jaromir-sukuba/vm_mini/readme.md

# 6-digit handheld digital volt-ohm-meter
This is repository for JVO-2
This readme is still incomplete. Find more information here
https://www.eevblog.com/forum/metrology/diy-6-digit-handheld-volohmmeter/
https://imgur.com/a/50MBxly
