jaromir-sukuba/vm_mini/mech/LM399_cover_part1.stl

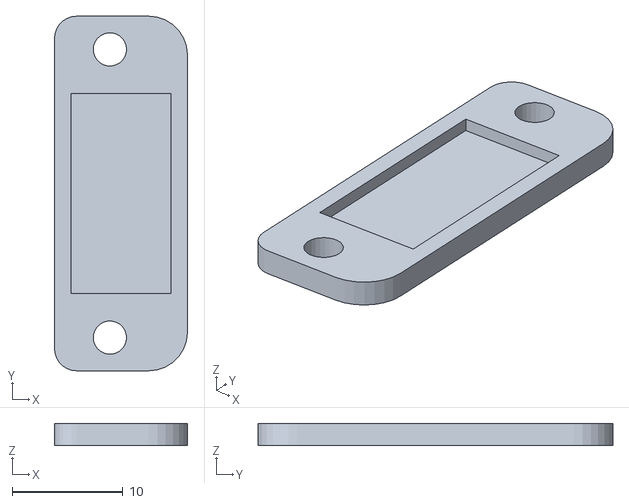
[picture p1: CAD file, 2020-03-22]
mech/LM399_cover_part1.stl
12.0 x 32.0 x 2.00
