jaromir-sukuba/vm_mini/mech/LM399_cover_part2.stl

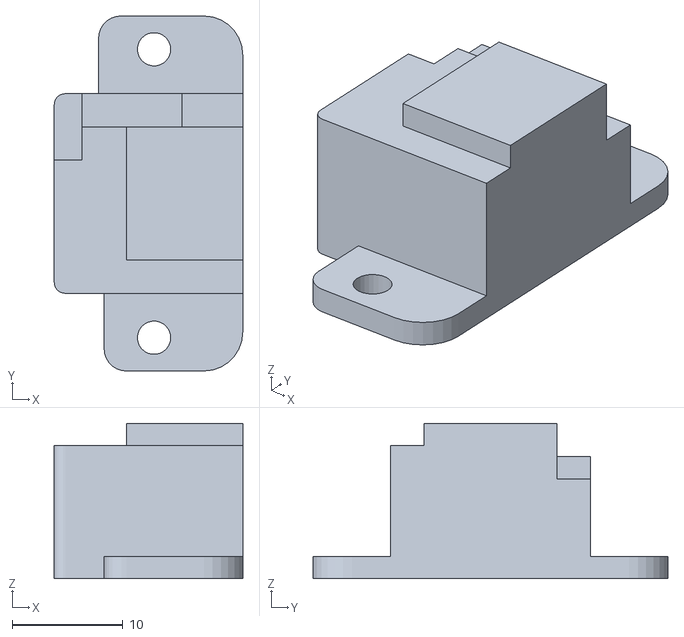
[picture p2: CAD file, 2020-03-22]
mech/LM399_cover_part2.stl
17.0 x 32.0 x 14.0
