jaromir-sukuba/vm_mini/schematics_pdf/vm_mini_analog_board.pdf

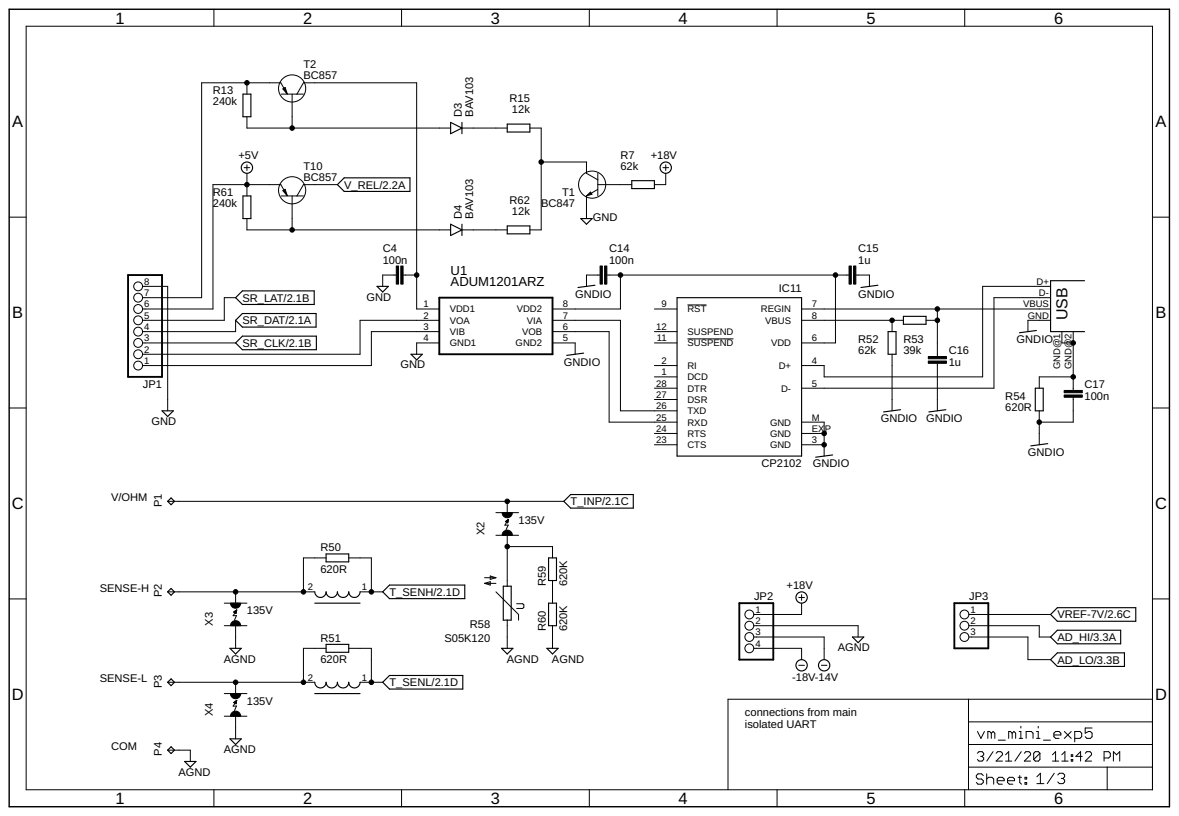
[picture p3: page 1]

D+D- VBUS GND GND@1 GND@2

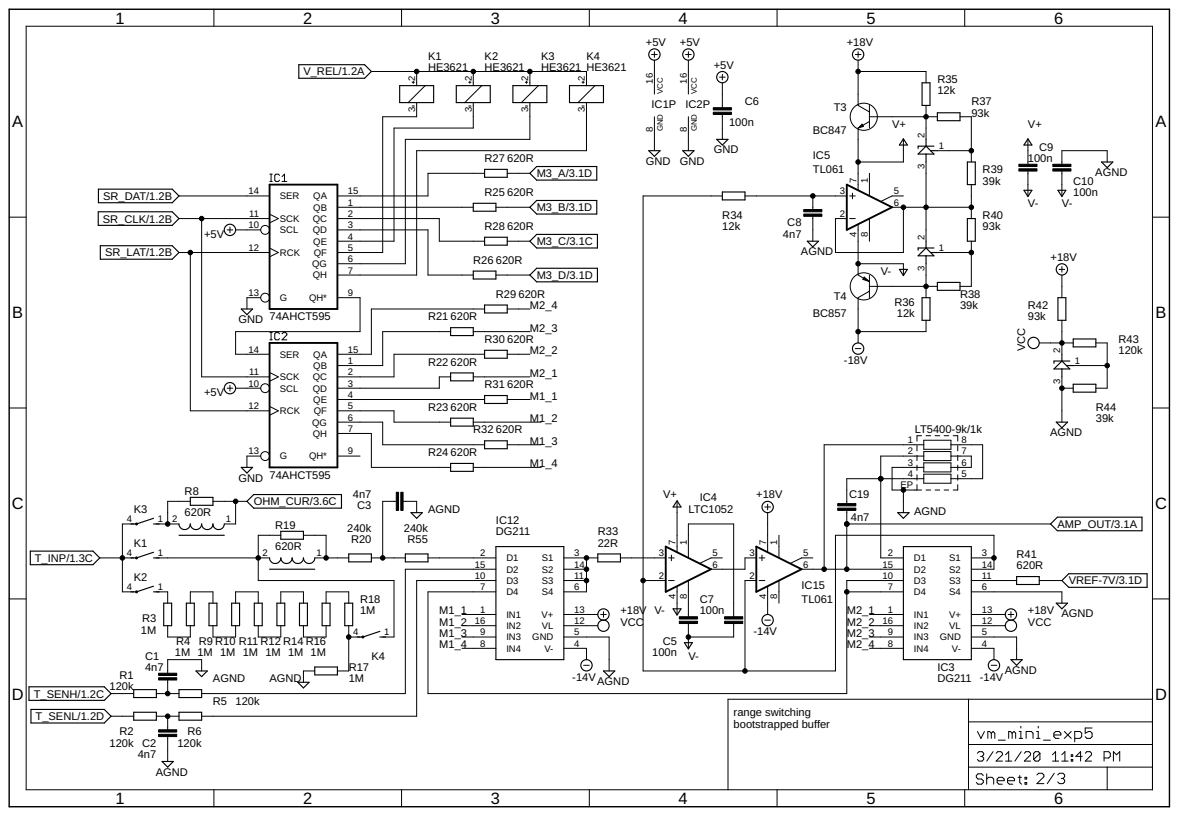
[picture p4: page 2]

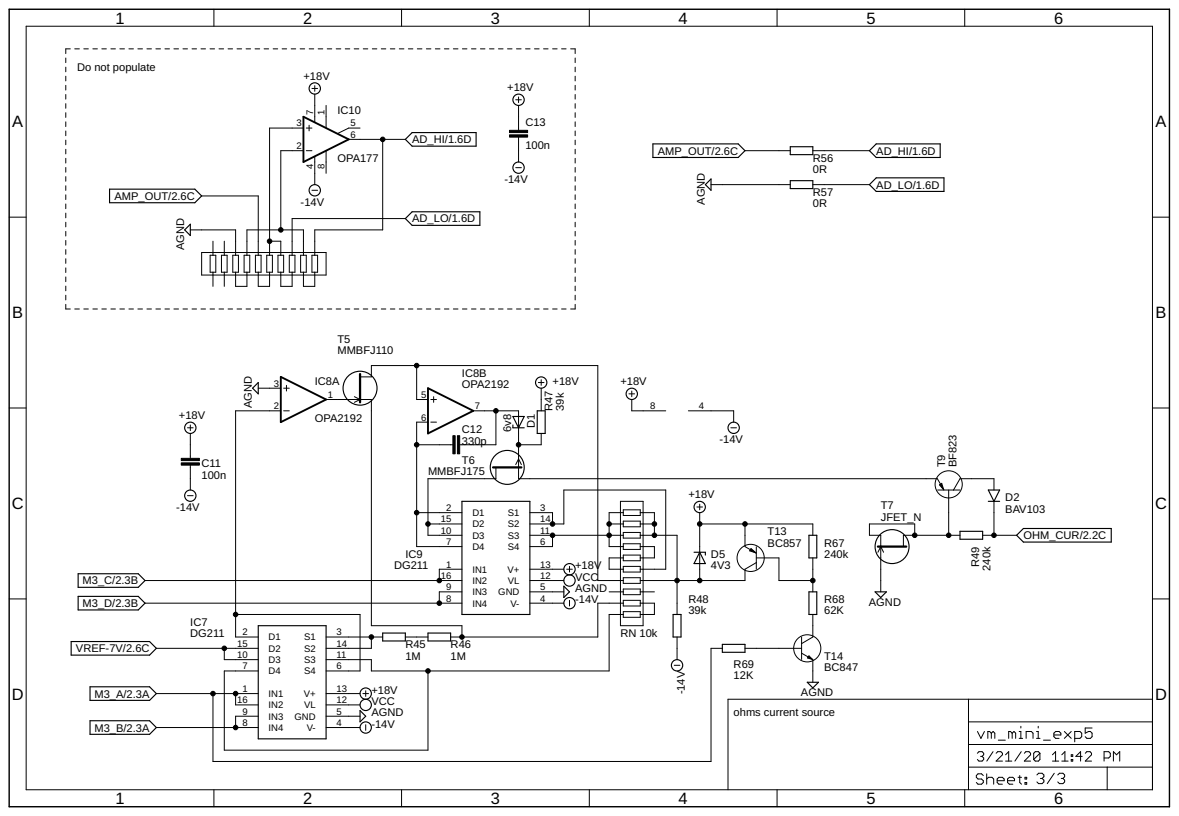
[picture p5: page 3]

11 S4
