jaromir-sukuba/vm_mini/mech/KM-103.pdf

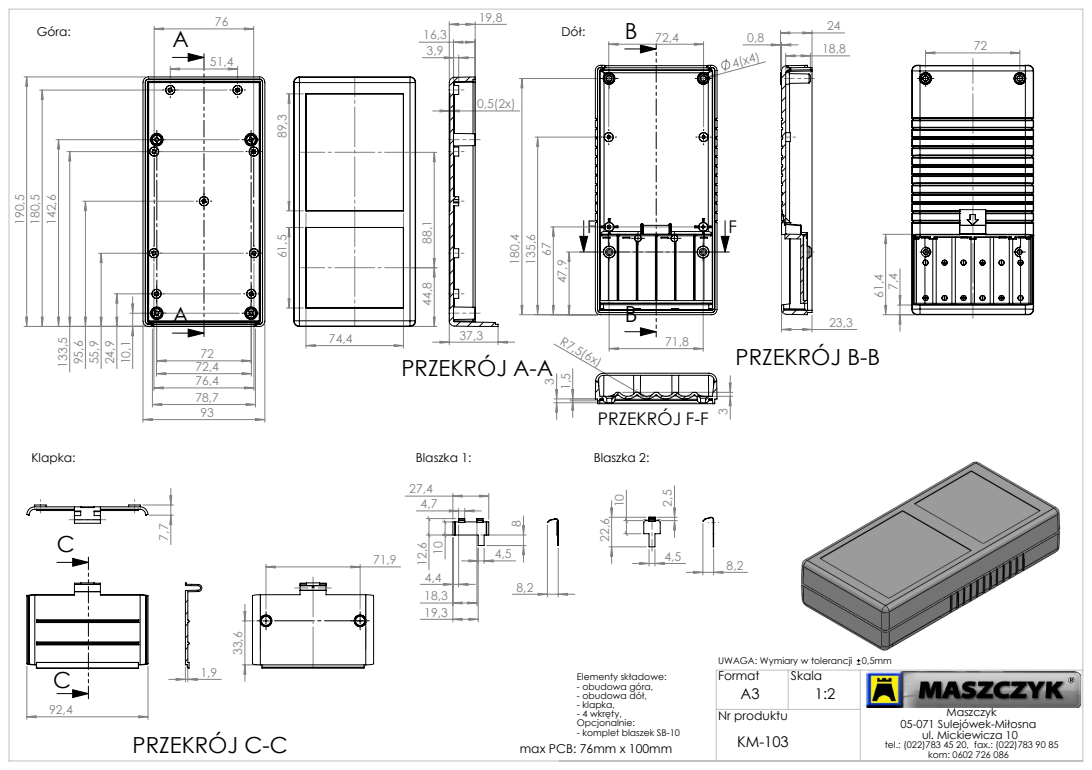
[picture p6: page 1]
PRZEKRÓJ A-A; PRZEKRÓJ B-B; PRZEKRÓJ C-C 7,7; PRZEKRÓJ F-F; Klapka:; Blaszka 1:; Blaszka 2:; max PCB: 76mm x 100mm; kom: 0602 726 086

UWAGA: Wymiary w tolerancji 0,5mm
Nr produktu

Elementy składowe:
- obudowa góra,
- obudowa dół,
- klapka,
- 4 wkręty,
Opcjonalnie:
- komplet blaszek SB-10

ul. Mickiewicza 10 05-071 Sulejówek-Miłosna
tel.: (022)783 45 20, fax.: (022)783 90 85
