jaromir-sukuba/vm_mini/mech/panel2a.pdf

+0 | +0.5 | +1

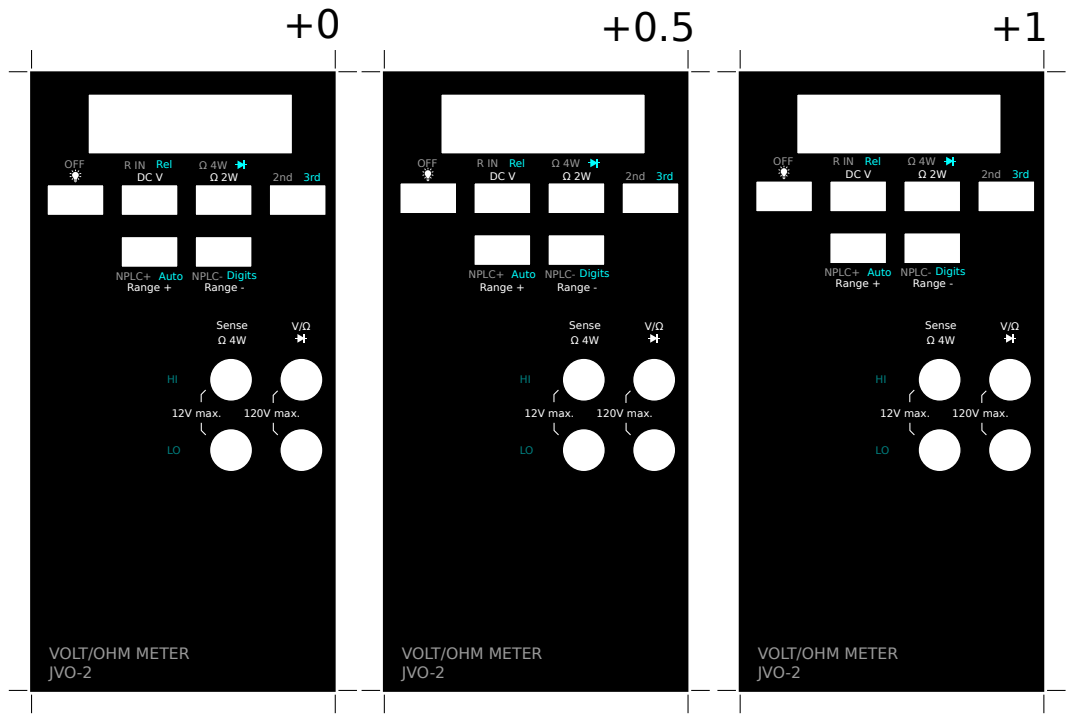
[picture p7: page 1]
OFF; Auto; Range -; NPLC- Digits; Range +; Rel; NPLC+; Sense; 12V max.; 120V max.

VOLT/OHM METER
JVO-2
