jaromir-sukuba/vm_mini/pcb_eagle/vm_mini_main3a.brd

## EAGLE design pcb_eagle/vm_mini_main3a.brd (2020-03-22)

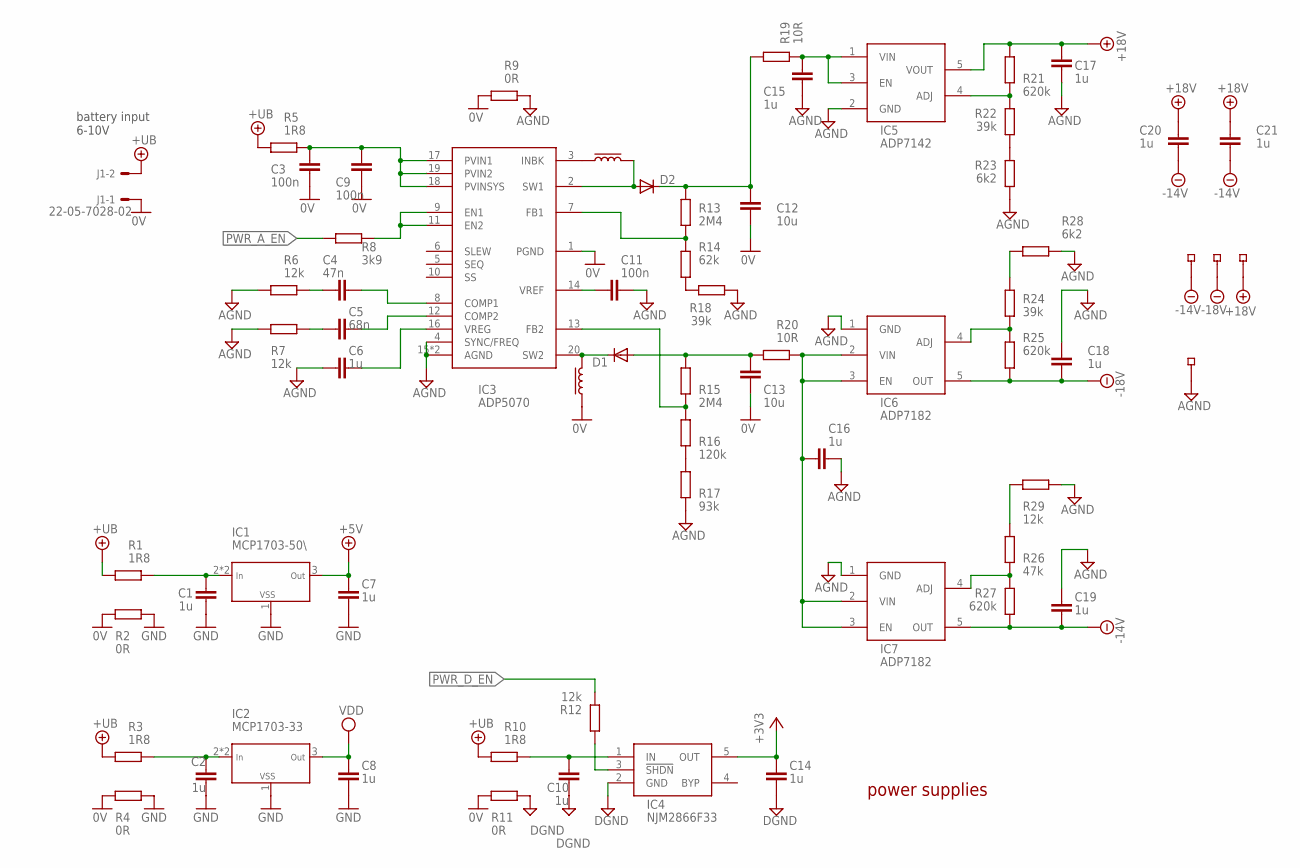
[picture p16: schematic vm_mini_main3a.sch, sheet 1]

Parts:
C1, C2, C6, C7, C8, C10, C14, C15, C16, C17, C18, C19, C20, C21: 1u; R0805
C3, C9, C11: 100n; R0805
C4: 47n; R0805
C5: 68n; R0805
C12, C13: 10u; R0805
D1, D2: DIODE-MINIMELF; MINIMELF
IC1: MCP1703-50\; SOT89
IC2: MCP1703-33; SOT89
IC3: ADP5070; TSSOP20-EP
IC4: NJM2866F33; SOT23-5
IC5: ADP7142; SOT23-5L
IC6, IC7: ADP7182; SOT23-5L
J1: 22-05-7028-02; 7395-02
L1, L2: INDUCTORBOURNS_SRP7030; BOURNS_SRP7030
R1, R3, R5, R10: 1R8; R_MINIMELF
R2, R4, R9, R11: 0R; R_MINIMELF
R6, R7, R12, R29: 12k; R_MINIMELF
R8: 3k9; R_MINIMELF
R13, R15: 2M4; R_MINIMELF
R14: 62k; R_MINIMELF
R16: 120k; R_MINIMELF
R17: 93k; R_MINIMELF
R18, R22, R24: 39k; R_MINIMELF
R19, R20: 10R; R_MINIMELF
R21, R25, R27: 620k; R_MINIMELF
R23, R28: 6k2; R_MINIMELF
R26: 47k; R_MINIMELF
TP1, TP2, TP3, TP4: TEST_PADSMD_35X2; TP_SMD_35X2

Connections:
0V: C3.2, C9.2, C12.2, C13.1, IC3.1 (PGND), J1.1, L1.P$1, R2.P$2 (2), R4.P$2 (2), R9.P$2 (2), R11.P$2 (2)
+3V3: C14.2, IC4.5 (OUT); also elsewhere on the board
+5V: C7.2, IC1.3 (OUT); also elsewhere on the board
+18V: C17.1, C20.1, C21.1, IC5.5 (VOUT), R21.P$2 (2), TP3.P$1; also elsewhere on the board
+UB: J1.2, R1.P$2 (2), R3.P$2 (2), R5.P$2 (2), R10.P$2 (2); also elsewhere on the board
-14V: C19.2, C20.2, C21.2, IC7.5 (OUT), R27.P$2 (2), TP1.P$1; also elsewhere on the board
-18V: C18.2, IC6.5 (OUT), R25.P$2 (2), TP2.P$1; also elsewhere on the board
AGND: C6.1, C11.1, C15.2, C16.2, C17.2, C18.1, C19.1, IC3.4 (SYNC/FREQ), IC3.15 (AGND), IC3.EP (AGND), IC5.2 (GND), IC6.1 (GND), IC7.1 (GND), R6.P$2 (2), R7.P$2 (2), R9.P$1 (1), R17.P$1 (1), R18.P$2 (2), R23.P$2 (2), R28.P$2 (2), R29.P$2 (2), TP4.P$1; also elsewhere on the board
DGND: C10.1, C14.1, IC4.2 (GND), R11.P$1 (1); also elsewhere on the board
GND: C1.1, C2.1, C7.1, C8.1, IC1.1 (VSS), IC2.1 (VSS), R2.P$1 (1), R4.P$1 (1); also elsewhere on the board
unnamed: IC3.9 (EN1), IC3.11 (EN2), R8.P$1 (1)
unnamed: IC4.3 (!SHDN), R12.P$2 (2)
unnamed: R24.P$2 (2), R28.P$1 (1)
unnamed: C16.1, IC6.2 (VIN), IC6.3 (EN), IC7.2 (VIN), IC7.3 (EN), R20.P$1 (1)
unnamed: C15.1, IC5.1 (VIN), IC5.3 (EN), R19.P$1 (1)
unnamed: IC3.3 (INBK), L2.P$1
unnamed: D1.C, IC3.20 (SW2), L1.P$2
unnamed: D2.A, IC3.2 (SW1), L2.P$2
unnamed: C3.1, C9.1, IC3.17 (PVIN1), IC3.18 (PVINSYS), IC3.19 (PVIN2), R5.P$1 (1)
unnamed: IC5.4 (ADJ), R21.P$1 (1), R22.P$1 (1)
unnamed: C11.2, IC3.14 (VREF)
unnamed: C12.1, D2.C, R13.P$1 (1), R19.P$2 (2)
unnamed: C4.1, R6.P$1 (1)
unnamed: IC3.13 (FB2), R15.P$1 (1), R16.P$2 (2)
unnamed: C5.1, R7.P$1 (1)
unnamed: IC3.7 (FB1), R13.P$2 (2), R14.P$1 (1)
unnamed: IC6.4 (ADJ), R24.P$1 (1), R25.P$1 (1)
unnamed: C4.2, IC3.8 (COMP1)
unnamed: C5.2, IC3.12 (COMP2)
unnamed: C6.2, IC3.16 (VREG)
unnamed: C13.2, D1.A, R15.P$2 (2), R20.P$2 (2)
unnamed: C10.2, IC4.1 (IN), R10.P$1 (1)
unnamed: C2.2, IC2.2 (IN), IC2.2@1 (IN), R3.P$1 (1)
unnamed: C1.2, IC1.2 (IN), IC1.2@1 (IN), R1.P$1 (1)
unnamed: IC7.4 (ADJ), R26.P$1 (1), R27.P$1 (1)
unnamed: R22.P$2 (2), R23.P$1 (1)
unnamed: R26.P$2 (2), R29.P$1 (1)
unnamed: R16.P$1 (1), R17.P$2 (2)
unnamed: R14.P$2 (2), R18.P$1 (1)
PWR_A_EN: R8.P$2 (2); also elsewhere on the board
PWR_D_EN: R12.P$1 (1); also elsewhere on the board
VDD: C8.2, IC2.3 (OUT); also elsewhere on the board

Notes on the sheet:
power supplies
battery input 6-10V

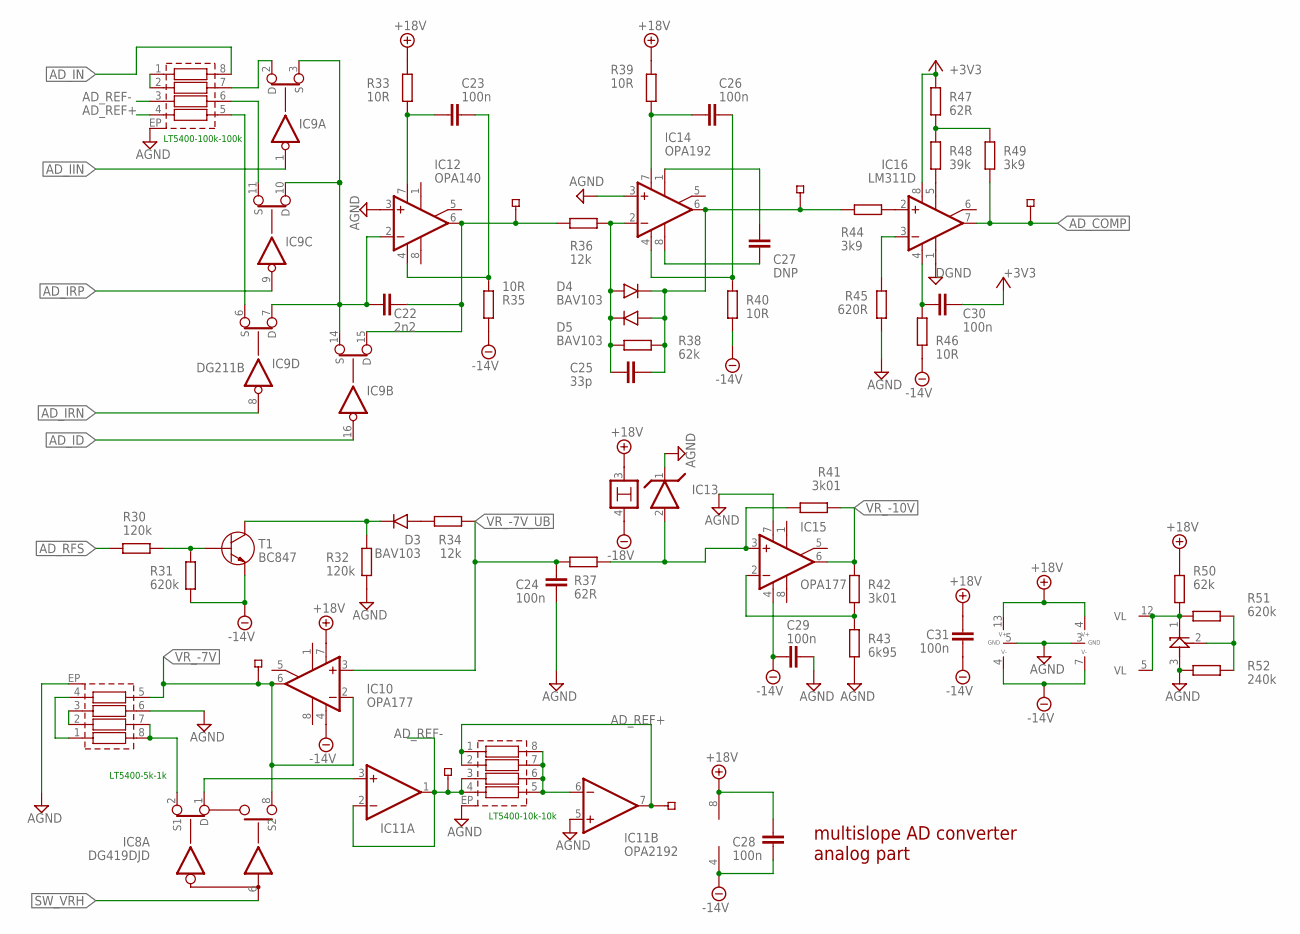
[picture p17: schematic vm_mini_main3a.sch, sheet 2]

Parts:
C22: 2n2; C150-054X183
C23, C26, C28, C29, C30, C31: 100n; R0805
C24: 100n; C050-035X075
C25: 33p; R_MINIMELF
C27: DNP; R_MINIMELF
D3, D4, D5: BAV103; SOD-80
IC8: DG419DJD; SO08
IC9: DG211B; SO16
IC10, IC15: OPA177; SO08
IC11: OPA2192; SO08
IC12: OPA140; SO08
IC13: LM399H; TO39/4
IC14: OPA192; SO08
IC16: LM311D; SO08
IC17: TL431_SOT23; SOT23
R30, R32: 120k; R_MINIMELF
R31, R51: 620k; R_MINIMELF
R33, R35, R39, R40, R46: 10R; R_MINIMELF
R34, R36: 12k; R_MINIMELF
R37, R47: 62R; R_MINIMELF
R38, R50: 62k; R_MINIMELF
R41, R42: 3k01; R_TR191
R43: 6k95; R_TR191
R44, R49: 3k9; R_MINIMELF
R45: 620R; R_MINIMELF
R48: 39k; R_MINIMELF
R52: 240k; R_MINIMELF
RN1: LT5400-5k-1k; MSOP8-EP
RN2: LT5400-100k-100k; MSOP8-EP
RN3: LT5400-10k+10k; MSOP8-EP
T1: BC847; SOT23
TP5, TP6, TP7, TP8, TP9, TP21: TEST_PADSMD_35X2; TP_SMD_35X2

Connections:
+3V3: C30.1, IC16.8 (V+), R47.P$2 (2); also elsewhere on the board
+18V: C28.2, C31.2, IC8.4 (V+), IC9.13 (V+), IC10.7 (V+), IC11.8 (V+), IC13.3, R33.P$2 (2), R39.P$2 (2), R50.P$1 (1); also elsewhere on the board
-14V: C28.1, C29.1, C31.1, IC8.7 (V-), IC9.4 (V-), IC10.4 (V-), IC11.4 (V-), IC15.4 (V-), R31.P$1 (1), R35.P$2 (2), R40.P$2 (2), R46.P$2 (2), T1.2 (E); also elsewhere on the board
-18V: IC13.4; also elsewhere on the board
AD_COMP: IC16.7 (OUT), R49.P$1 (1), TP7.P$1; also elsewhere on the board
AD_ID: IC9.16 (IN); also elsewhere on the board
AD_IIN: IC9.1 (IN); also elsewhere on the board
AD_IN: RN2.8 (R1B); also elsewhere on the board
AD_IRN: IC9.8 (IN); also elsewhere on the board
AD_IRP: IC9.9 (IN); also elsewhere on the board
AD_REF+: IC11.7 (OUT), RN2.4 (R4A), RN3.1 (R1A), RN3.2 (R2A), TP8.P$1
AD_REF-: IC11.1 (OUT), IC11.2 (-IN), RN2.3 (R3A), RN3.3 (R3A), RN3.4 (R4A), TP9.P$1
AD_RFS: R30.P$2 (2); also elsewhere on the board
AGND: C24.2, C29.2, IC8.3 (GND), IC9.5 (GND), IC11.5 (+IN), IC12.3 (+IN), IC13.1, IC14.3 (+IN), IC15.7 (V+), IC17.3 (A), R32.P$2 (2), R43.P$1 (1), R45.P$2 (2), R52.P$1 (1), RN1.6 (R3B), RN1.EP (SH), RN2.EP (SH), RN3.EP (SH); also elsewhere on the board
DGND: IC16.1 (GND); also elsewhere on the board
unnamed: C22.1, IC9.3 (S), IC9.7 (D), IC9.10 (D), IC9.14 (S), IC12.2 (-IN)
unnamed: IC15.2 (-IN), R42.P$2 (2), R43.P$2 (2)
unnamed: IC9.2 (D), RN2.7 (R2B)
unnamed: C22.2, IC9.15 (D), IC12.6 (OUT), R36.P$1 (1), TP5.P$1
unnamed: IC9.11 (S), RN2.6 (R3B)
unnamed: IC9.6 (S), RN2.5 (R4B)
unnamed: C23.2, IC12.7 (V+), R33.P$1 (1)
unnamed: C23.1, IC12.4 (V-), R35.P$1 (1)
unnamed: IC8.1 (D), IC11.3 (+IN)
unnamed: RN1.1 (R1A), RN1.4 (R4A)
unnamed: D3.A, R34.P$2 (2)
unnamed: IC8.2 (S1), RN1.7 (R2B), RN1.8 (R1B)
unnamed: IC13.2, IC15.3 (+IN), R37.P$1 (1), R41.P$2 (2)
unnamed: C25.P$1 (1), D4.A, D5.K, IC14.2 (-IN), R36.P$2 (2), R38.P$1 (1)
unnamed: R30.P$1 (1), R31.P$2 (2), T1.1 (B)
unnamed: D3.K, R32.P$1 (1), T1.3 (C)
unnamed: RN2.1 (R1A), RN2.2 (R2A)
unnamed: IC11.6 (-IN), RN3.5 (R4B), RN3.6 (R3B), RN3.7 (R2B), RN3.8 (R1B)
unnamed: RN1.2 (R2A), RN1.3 (R3A)
unnamed: C26.2, IC14.7 (V+), R39.P$1 (1)
unnamed: C26.1, IC14.4 (V-), R40.P$1 (1)
unnamed: C25.P$2 (2), D4.K, D5.A, IC14.6 (OUT), R38.P$2 (2), R44.P$1 (1), TP6.P$1
unnamed: IC16.5 (ON), R48.P$1 (1)
unnamed: R47.P$1 (1), R48.P$2 (2), R49.P$2 (2)
unnamed: C30.2, IC16.4 (V-), R46.P$1 (1)
unnamed: IC16.2 (+IN), R44.P$2 (2)
unnamed: IC16.3 (-IN), R45.P$1 (1)
unnamed: IC17.2 (R), R51.P$2 (2), R52.P$2 (2)
unnamed: IC8.5 (VL), IC9.12 (VL), IC17.1 (C), R50.P$2 (2), R51.P$1 (1)
unnamed: C27.P$1 (1), IC14.8 (OPT)
unnamed: C27.P$2 (2), IC14.1 (ON1)
SW_VRH: IC8.6 (IN)
VR_-7V: IC8.8 (S2), IC10.2 (-IN), IC10.6 (OUT), RN1.5 (R4B), TP21.P$1; also elsewhere on the board
VR_-7V_UB: C24.1, IC10.3 (+IN), R34.P$1 (1), R37.P$2 (2)
VR_-10V: IC15.6 (OUT), R41.P$1 (1), R42.P$1 (1)

Notes on the sheet:
LT5400-5k-1k
LT5400-10k-10k
LT5400-100k-100k
multislope AD converter analog part

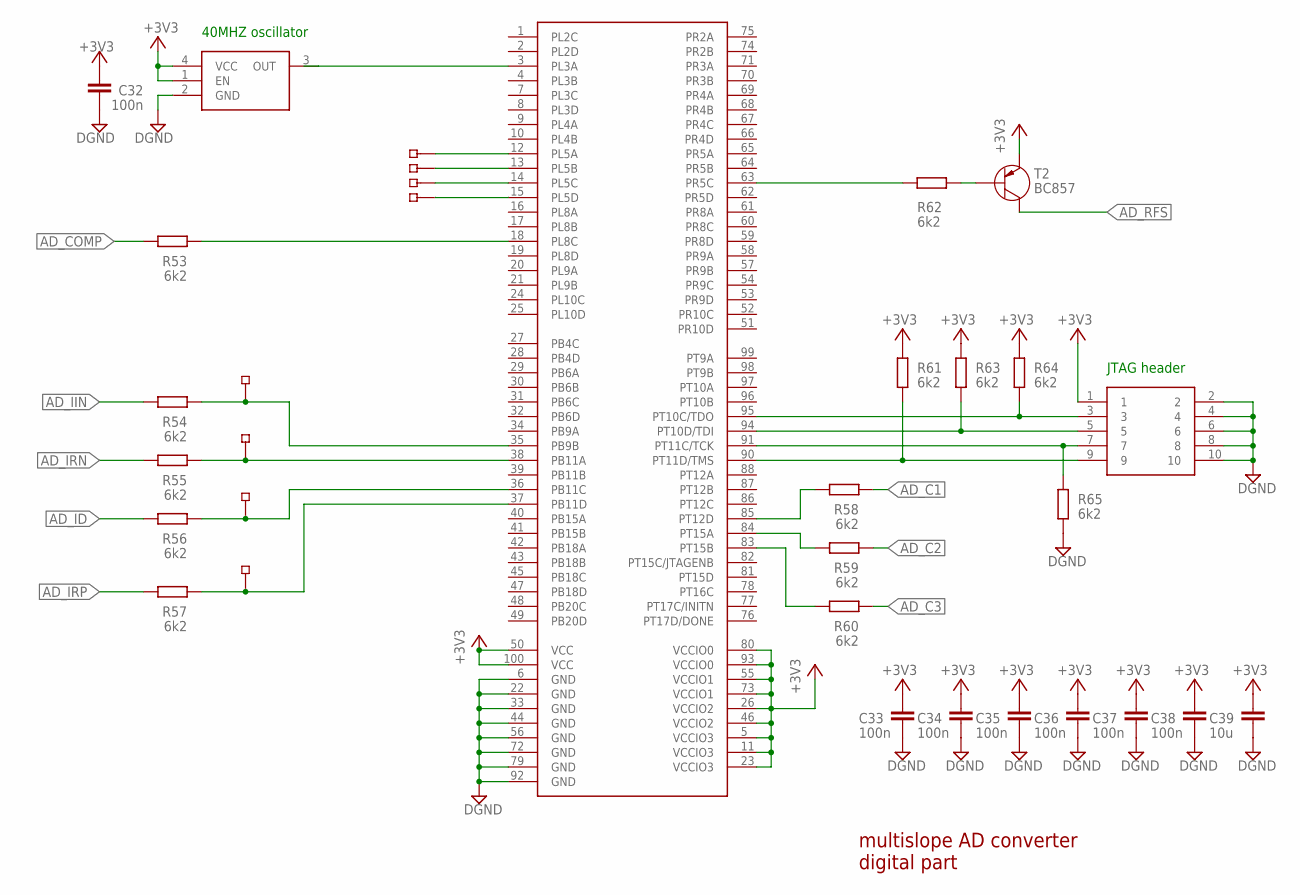
[picture p18: schematic vm_mini_main3a.sch, sheet 3]

Parts:
C32, C33, C34, C35, C36, C37, C38: 100n; R0805
C39: 10u; R0805
CON1: IDC_10_2MM; IDC_20_10P
IC18: MACHXO2-1200-TQ100T100; TQFP100
OSC1: OSC3225; OSC_3225
R53, R54, R55, R56, R57, R58, R59, R60, R61, R62, R63, R64, R65: 6k2; R_MINIMELF
T2: BC857; SOT23
TP10, TP11, TP12, TP13, TP14, TP15, TP16, TP17: TEST_PADSMD_35X2; TP_SMD_35X2

Connections:
+3V3: C32.2, C33.2, C34.2, C35.2, C36.2, C37.2, C38.2, C39.2, CON1.1, IC18.5 (VCCIO3), IC18.11 (VCCIO3), IC18.23 (VCCIO3), IC18.26 (VCCIO2), IC18.46 (VCCIO2), IC18.50 (VCC), IC18.55 (VCCIO1), IC18.73 (VCCIO1), IC18.80 (VCCIO0), IC18.93 (VCCIO0), IC18.100 (VCC), OSC1.1 (EN), OSC1.4 (VCC), R61.P$1 (1), R63.P$1 (1), R64.P$1 (1), T2.2 (C); also elsewhere on the board
AD_C1: R58.P$2 (2); also elsewhere on the board
AD_C2: R59.P$2 (2); also elsewhere on the board
AD_C3: R60.P$2 (2); also elsewhere on the board
AD_COMP: R53.P$1 (1); also elsewhere on the board
AD_ID: R56.P$1 (1); also elsewhere on the board
AD_IIN: R54.P$1 (1); also elsewhere on the board
AD_IRN: R55.P$1 (1); also elsewhere on the board
AD_IRP: R57.P$1 (1); also elsewhere on the board
AD_RFS: T2.3 (E); also elsewhere on the board
DGND: C32.1, C33.1, C34.1, C35.1, C36.1, C37.1, C38.1, C39.1, CON1.2, CON1.4, CON1.6, CON1.8, CON1.10, IC18.6 (GND), IC18.22 (GND), IC18.33 (GND), IC18.44 (GND), IC18.56 (GND), IC18.72 (GND), IC18.79 (GND), IC18.92 (GND), OSC1.2 (GND), R65.P$2 (2); also elsewhere on the board
unnamed: IC18.3 (PL3A), OSC1.3 (OUT)
unnamed: R62.P$1 (1), T2.1 (B)
unnamed: IC18.35 (PB9B), R54.P$2 (2), TP10.P$1
unnamed: CON1.9, IC18.90 (PT11D/TMS), R61.P$2 (2)
unnamed: CON1.7, IC18.91 (PT11C/TCK), R65.P$1 (1)
unnamed: CON1.5, IC18.94 (PT10D/TDI), R63.P$2 (2)
unnamed: CON1.3, IC18.95 (PT10C/TDO), R64.P$2 (2)
unnamed: IC18.84 (PT15A), R59.P$1 (1)
unnamed: IC18.36 (PB11C), R56.P$2 (2), TP13.P$1
unnamed: IC18.83 (PT15B), R60.P$1 (1)
unnamed: IC18.37 (PB11D), R57.P$2 (2), TP11.P$1
unnamed: IC18.38 (PB11A), R55.P$2 (2), TP12.P$1
unnamed: IC18.18 (PL8C), R53.P$2 (2)
unnamed: IC18.63 (PR5C), R62.P$2 (2)
unnamed: IC18.85 (PT12D), R58.P$1 (1)
unnamed: IC18.12 (PL5A), TP14.P$1
unnamed: IC18.13 (PL5B), TP15.P$1
unnamed: IC18.14 (PL5C), TP16.P$1
unnamed: IC18.15 (PL5D), TP17.P$1

Notes on the sheet:
multislope AD converter digital part
JTAG header
40MHZ oscillator
